Asghar267/RISC-V-AI-Accelerator/docs/images/fig13_datapath_with_accelerator.png

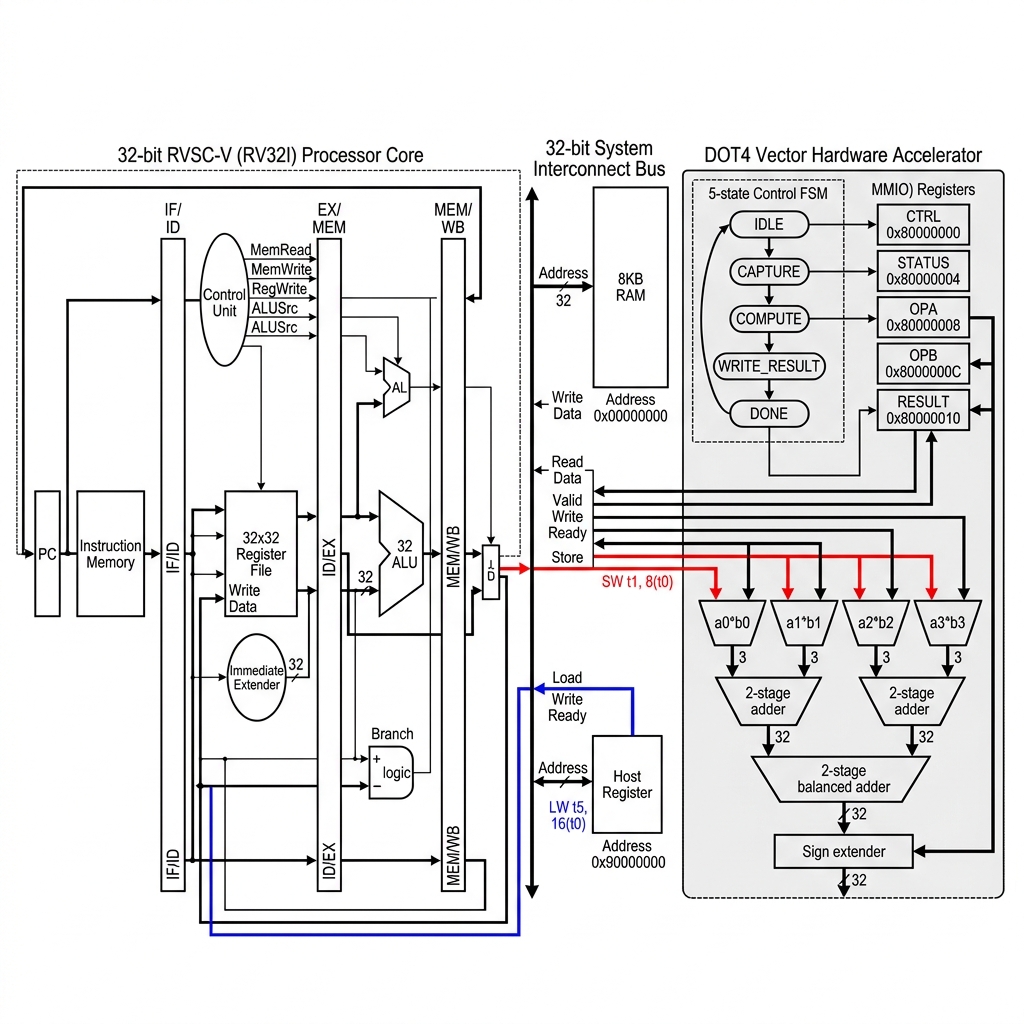
docs/images/fig13_datapath_with_accelerator.png
