Asghar267/RISC-V-AI-Accelerator/rtl/baseline/ram.v

`timescale 1ns/1ps
`default_nettype none

// Dual-Port / Single-Bus Asynchronous Read RAM Module initialized with program.hex
module ram #(
    parameter MEM_SIZE = 8192, // 8KB RAM
    parameter HEX_FILE = "program.hex"
) (
    input  wire        clk,
    input  wire        mem_valid,
    input  wire        mem_write,
    input  wire [3:0]  mem_wstrb,
    input  wire [31:0] mem_addr,
    input  wire [31:0] mem_wdata,
    output wire [31:0] mem_rdata,
    output wire        mem_ready
);

    reg [31:0] mem [0:(MEM_SIZE/4)-1];

    wire [31:0] word_addr = mem_addr[31:2];

    assign mem_ready = mem_valid;
    assign mem_rdata = (word_addr < (MEM_SIZE/4)) ? mem[word_addr] : 32'd0;

    integer i;
    initial begin
        for (i = 0; i < (MEM_SIZE/4); i = i + 1) begin
            mem[i] = 32'd0;
        end
        $readmemh(HEX_FILE, mem);
    end

    always @(posedge clk) begin
        if (mem_valid && mem_write) begin
            if (word_addr < (MEM_SIZE/4)) begin
                if (mem_wstrb[0]) mem[word_addr][7:0]   <= mem_wdata[7:0];
                if (mem_wstrb[1]) mem[word_addr][15:8]  <= mem_wdata[15:8];
                if (mem_wstrb[2]) mem[word_addr][23:16] <= mem_wdata[23:16];
                if (mem_wstrb[3]) mem[word_addr][31:24] <= mem_wdata[31:24];
            end
        end
    end
endmodule
`default_nettype wire
